Hexum064/dc31-badge-sao/PXL_20230720_001437175.jpg

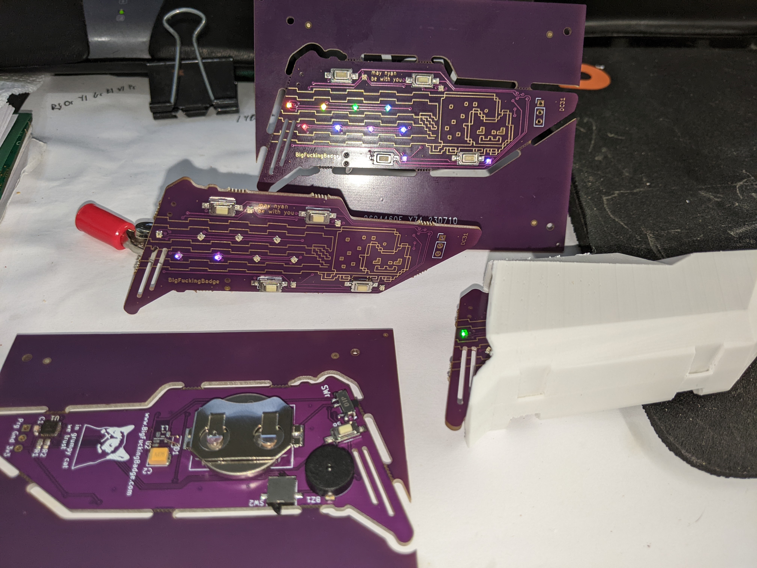
PXL_20230720_001437175.jpg
