Hexum064/dc31-badge-sao/dc31-badge-sao.kicad_pcb

## KiCad design dc31-badge-sao.kicad_pcb (2023-07-20)

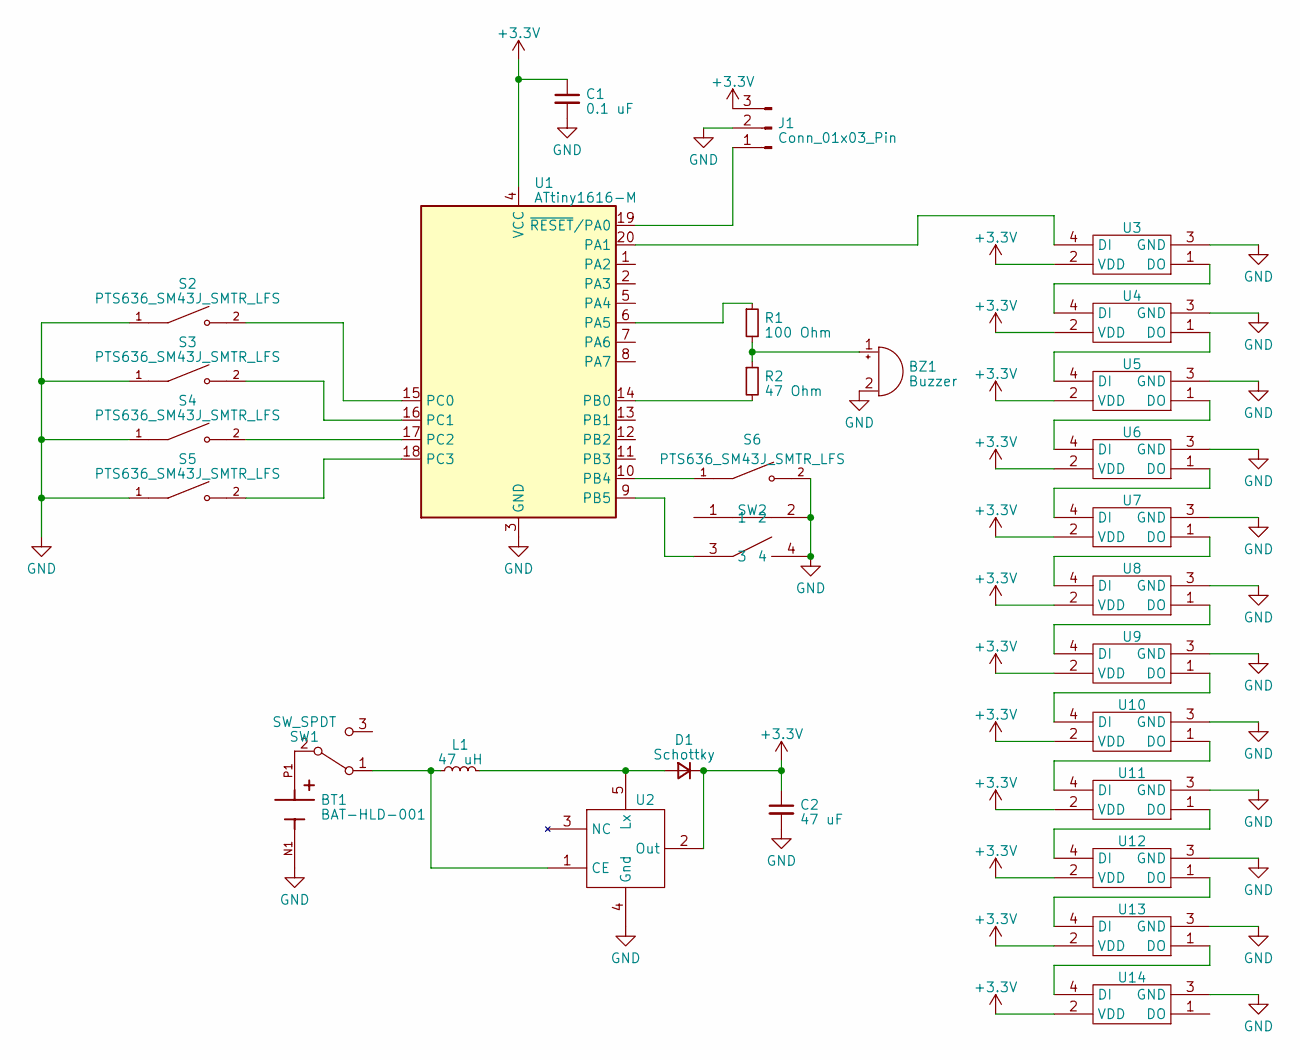
[picture p2: schematic dc31-badge-sao.kicad_sch]

Parts:
BT1: BAT-HLD-001; BAT_BAT-HLD-001; PARTREV C
BZ1: Buzzer; GSC1031YB-3V4000
C1: 0.1 uF; C_0603_1608Metric
C2: 47 uF; CP_EIA-3528-21_Kemet-B
D1: Schottky; D_SOD-323
J1: Conn_01x03_Pin; PinHeader_1x03_P2.54mm_Vertical
L1: 47 uH; L_0805_2012Metric
R1: 100 Ohm; R_0603_1608Metric
R2: 47 Ohm; R_0603_1608Metric
S2, S3, S4, S5, S6: PTS636_SM43J_SMTR_LFS; SW_PTS636_SM43J_SMTR_LFS; PARTREV 27 mar 19
SW1: SW_SPDT; MSS3VTR
SW2: TM-1627A
U1: ATtiny1616-M; VQFN-20-1EP_3x3mm_P0.4mm_EP1.7x1.7mm
U2: SOT-23-5
U3, U4, U5, U6, U7, U8, U9, U10, U11, U12, U13, U14: ws2812b-1010

Connections:
+3.3V: C1.1, C2.1, D1.1 (K), J1.3, L1.1, SW1.1 (A), U1.4 (VCC), U2.1 (CE), U2.2 (Out), U3.2 (VDD), U4.2 (VDD), U5.2 (VDD), U6.2 (VDD), U7.2 (VDD), U8.2 (VDD), U9.2 (VDD), U10.2 (VDD), U11.2 (VDD), U12.2 (VDD), U13.2 (VDD), U14.2 (VDD)
GND: BT1.N1, BZ1.2 (+), C1.2, C2.2, J1.2, S2.1, S3.1, S4.1, S5.1, S6.2, SW2.2, SW2.4, U1.3 (GND), U1.21 (GND), U2.4 (Gnd), U3.3 (GND), U4.3 (GND), U5.3 (GND), U6.3 (GND), U7.3 (GND), U8.3 (GND), U9.3 (GND), U10.3 (GND), U11.3 (GND), U12.3 (GND), U13.3 (GND), U14.3 (GND)
unnamed: BZ1.1 (-), R1.2, R2.1
unnamed: D1.2 (A), L1.2, U2.5 (Lx)
unnamed: J1.1, U1.19 (~RESET/PA0)
unnamed: BT1.P1, SW1.2 (B)
unnamed: U1.20 (PA1), U3.4 (DI)
unnamed: R1.1, U1.6 (PA5)
unnamed: R2.2, U1.14 (PB0)
unnamed: S6.1, U1.10 (PB4)
unnamed: SW2.3, U1.9 (PB5)
unnamed: S2.2, U1.15 (PC0)
unnamed: S3.2, U1.16 (PC1)
unnamed: S4.2, U1.17 (PC2)
unnamed: S5.2, U1.18 (PC3)
unnamed: U3.1 (DO), U4.4 (DI)
unnamed: U4.1 (DO), U5.4 (DI)
unnamed: U5.1 (DO), U6.4 (DI)
unnamed: U6.1 (DO), U7.4 (DI)
unnamed: U7.1 (DO), U8.4 (DI)
unnamed: U8.1 (DO), U9.4 (DI)
unnamed: U9.1 (DO), U10.4 (DI)
unnamed: U10.1 (DO), U11.4 (DI)
unnamed: U11.1 (DO), U12.4 (DI)
unnamed: U12.1 (DO), U13.4 (DI)
unnamed: U13.1 (DO), U14.4 (DI)

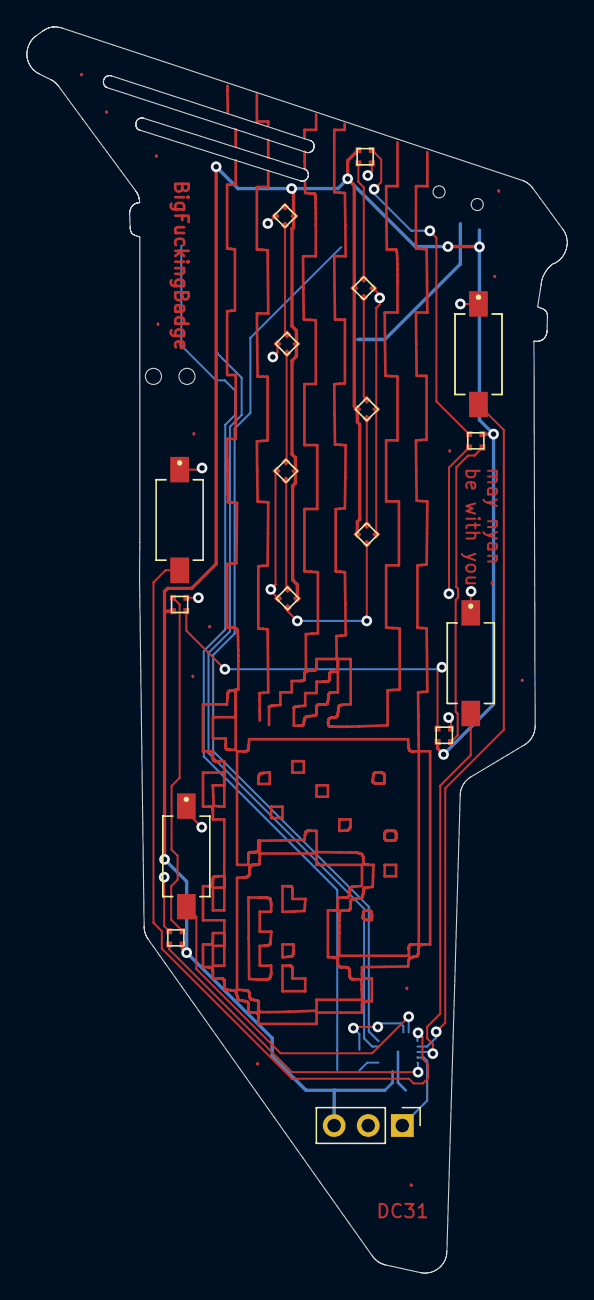
[picture p3: board dc31-badge-sao.kicad_pcb from above]

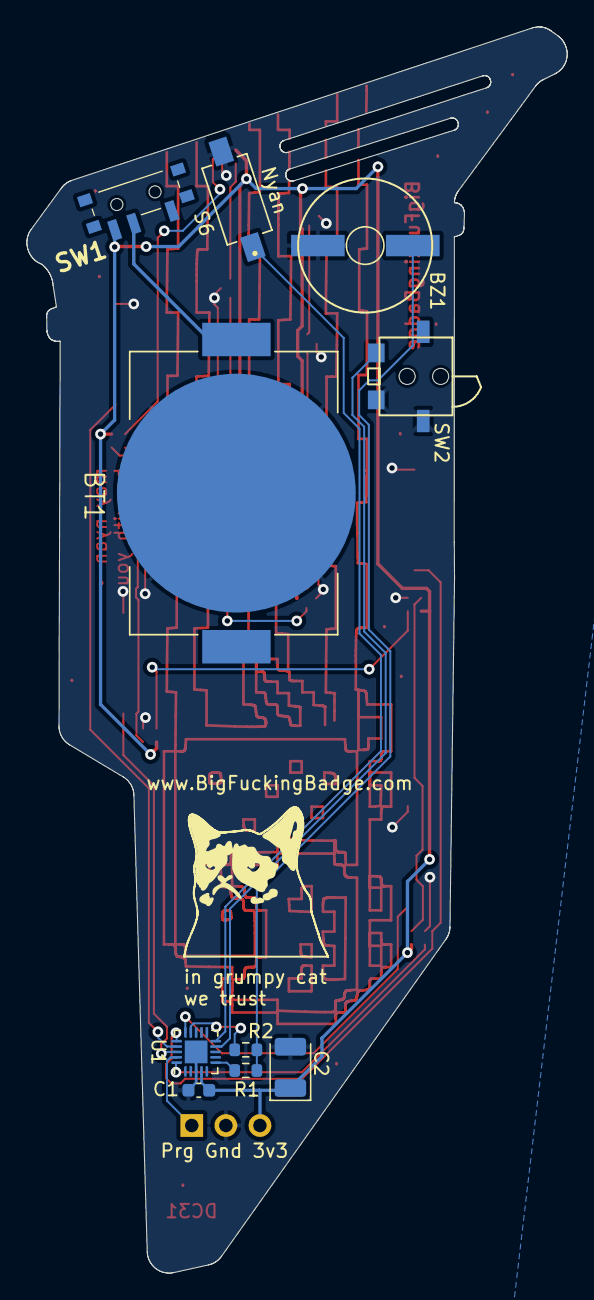
[picture p4: board dc31-badge-sao.kicad_pcb from below]

Board: 2 copper layers, 40.3 x 92.9 mm, 27 parts (10 on the bottom side), 25 nets.
