Hexum064/dc31-badge-sao/attiny1616-sao/attiny1616-sao/sound_data.h

/*
 * sound_data.h
 *
 * Created: 2023-07-09 19:18:24
 *  Author: Branden
 */ 


#ifndef SOUND_DATA_H_
#define SOUND_DATA_H_
#define NYAN_BPM_TIMER_PER 8700
#define NYAN_TREBLE_RESET 31
#define NYAN_BASS_RESET 2
#define GAME_BPM_TIMER_PER 9000 //slow
#define GAME_START_SIZE 18
#define GAME_WON_SIZE 10
#define GAME_LOST_SIZE 5
#include <avr/pgmspace.h>




static const uint8_t nyanTreble[] PROGMEM = {0x12,0x11,0xf,0x0,0xa,0x11,0x12,0x11,0xf,0xa,0x6,0x5,0x6,0xb,0xa,0x0,0xf,0x0,0x12,0x11,0xf,0x0,0x4a,0x8,0xb,0xa,0x8,0x5,0x6,0x5,0x8,
	0x4f,0x4d,0x15,0x52,0x14,0x13,0x14,0x56,0x56,0x54,0x53,0x13,0x14,0x16,0x14,0x12,0xf,0xd,0x12,0xf,0x14,0x12,0x16,0x14,0x16,0x52,0x4f,0xd,0x12,0xf,0x14,0x12,0x16,0x15,0x12,0x13,0x14,0x16,0x14,0x53,0x16,0x14,0x12,0xf,0x14,0x13,0x14,0x16,0x54,0x56,0x54,0x4f,0x4d,0x15,0x52,0x14,0x13,0x14,0x56,0x56,0x54,0x53,0x13,0x14,0x16,0x14,0x12,0xf,0xd,0x12,0xf,0x14,0x12,0x16,0x14,0x16,0x52,0x4f,0xd,0x12,0xf,0x14,0x12,0x16,0x15,0x12,0x13,0x14,0x16,0x14,0x53,0x16,0x14,0x12,0xf,0x14,0x13,0x14,0x16,0x54,0x56,0x56,0x56,0x1b,0x19,0x56,0x1b,0x19,0x16,0x14,0x12,0x16,0x11,0x12,0x11,0xf,0x56,0x56,0x1b,0x19,0x16,0x1b,0x11,0x12,0x14,0x16,0x1d,0x1e,0x1d,0x1b,0x56,0x1b,0x19,0x56,0x1b,0x19,0x16,0x16,0x14,0x12,0x16,0x1b,0x19,0x1b,0x56,0x16,0x17,0x16,0x1b,0x19,0x16,0x11,0x12,0x11,0xf,0x56,0x57,0x56,0x1b,0x19,0x56,0x1b,0x19,0x16,0x14,0x12,0x16,0x11,0x12,0x11,0xf,0x56,0x56,0x1b,0x19,0x16,0x1b,0x11,0x12,0x14,0x16,0x1d,0x1e,0x1d,0x1b,0x56,0x1b,0x19,0x56,0x1b,0x19,0x16,0x16,0x14,0x12,0x16,0x1b,0x19,0x1b,0x56,0x16,0x17,0x16,0x1b,0x19,0x16,0x11,0x12,0x11,0xf,0x56,0x54};
static const uint8_t nyanExtTreble[] PROGMEM = {0x0,0x0,0x0,0x0,
	0x0,0x0,0x0,0x0,0x0,0x0,0x0,0x0,0x0,0x0,0x0,0x0,0x0,0x0,0x0,0x0,0x0,0x0,0x0,0x0,0x0,0x0,0x0,0x0,0x0,0x0,0x0};


static const uint8_t nyanBass[] PROGMEM = {0x00, 0x00, 
	0x75,0x69,0x73,0x67,0x76,0x6a,0x71,0x65,0x78,0x6c,0x73,0x67,0x3a,0x2e,0x7a,0x78,0x76};
static const uint8_t nyanExtBass[] PROGMEM = {0x03, 
	0x0,0x0,0x0};


static const uint16_t noteClocks[] = {94,100,106,112,119,126,133,141,149,158,168,178,188,199,211,224,237,251,266,282,299,316,335,355,376,399,422,447,474,502,532,564,597,633,670,710,752,797,845,895,948,1004,1064,1127,1194,1265,1341,1420,1505,1594,1689,1790,1896,2009,2128,2255,2389,2531,2681,2841,3010,3189,3378};
//static const uint16_t noteClocks[] = {1204,1276,1352,1432,1516,1608,1704,1804,1912,2024,2144,2272,2408,2552,2704,2864,3032,3216,3404,3608,3824,4048,4292,4544,4816,5104,5404,5728,6068,6428,6812,7216,7644,8100,8580,9092,9632,10204,10812,11456,12136,12856,13620,14432,15288,16200,17160,18180,19264,20408,21620,22908,24268,25712,27240,28860,30576,32392,34324,36364,38528,40816,43244,45820};

static const uint8_t gameStartupNotes[] = {32 + 64, 32, 32, 32, 32 + 128, 0, 30 + 64, 30, 30, 30, 30 + 128, 0, 28 + 64, 28, 28, 28, 28 + 128, 0};
static const uint8_t gameWonNotes[] = {21, 21, 21, 21 + 128, 25 + 128, 23 + 128, 21 + 128, 22, 21 + 192, 0 };
static const uint8_t gameLostNotes[] = {33 + 128, 37 + 128, 41 + 128, 45 + 192, 0}; 
static const uint8_t gameButtonNotes[] = {35, 32, 28, 23};
	
#endif /* SOUND_DATA_H_ */
