Hexum064/dc31-badge-sao/(commit log)

2023-07-13 added a reset feature
    [dc31-badge-sao.kicad_pcb]
2023-07-20 updates after receiving protos
    [dc31-badge-sao-B_Cu.gbl, dc31-badge-sao-B_Mask.gbs, dc31-badge-sao-B_Paste.gbp, dc31-badge-sao-B_Silkscreen.gbo, dc31-badge-sao-Edge_Cuts.gm1, dc31-badge-sao-F_Cu.gtl, dc31-badge-sao-F_Mask.gts, dc31-badge-sao-F_Paste.gtp]
